guberti/FTC-8103-RelicRecovery/README.md

# ftc_app
Please see https://github.com/EastsidePreparatorySchool/ftc_app. This project has been moved there.
