guberti/FTC-8103-RelicRecovery/Parts/ftc robot/editedThingySlide.stl

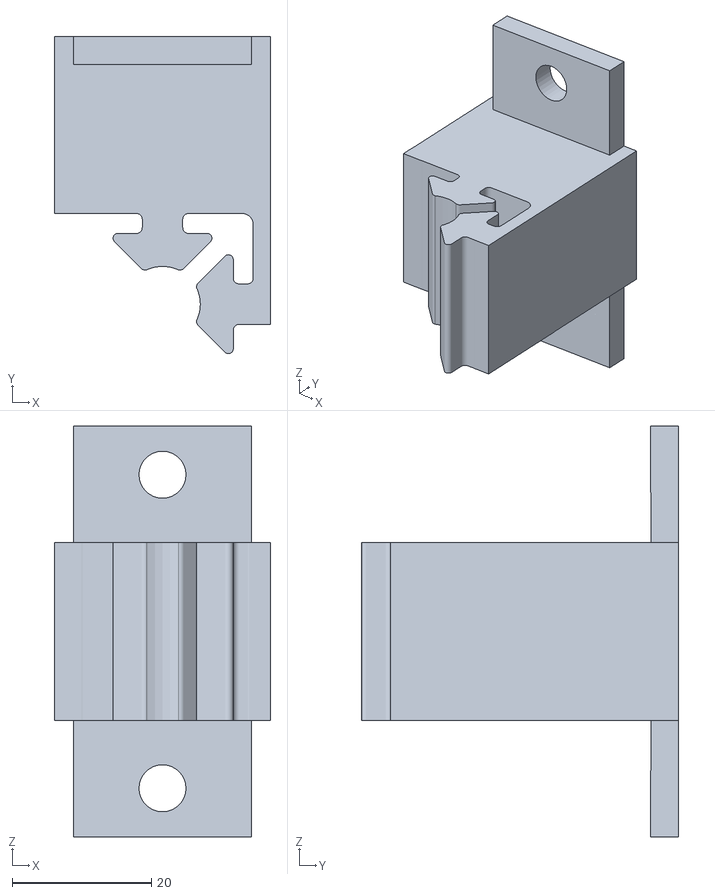
[picture p23: CAD file, 2017-08-23]
Parts/ftc robot/editedThingySlide.stl
31.0 x 45.6 x 59.0
