guberti/FTC-8103-RelicRecovery/Parts/ftc robot/electronics/MRI45-2201_Device_Interface.stp

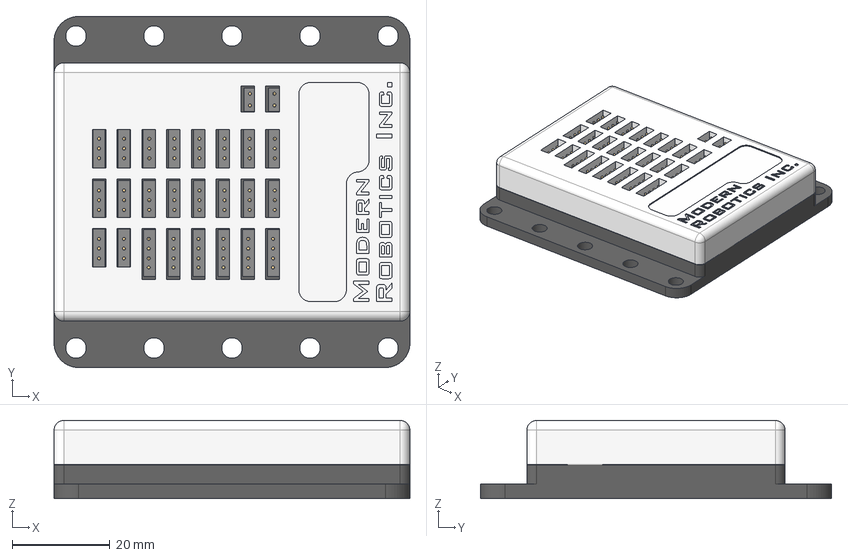
[picture p24: CAD file, 2017-08-23]
Parts/ftc robot/electronics/MRI45-2201_Device_Interface.stp
73.0 x 72.0 x 16.0 mm
