guberti/FTC-8103-RelicRecovery/Parts/Pin Covers/pincovers1.stl

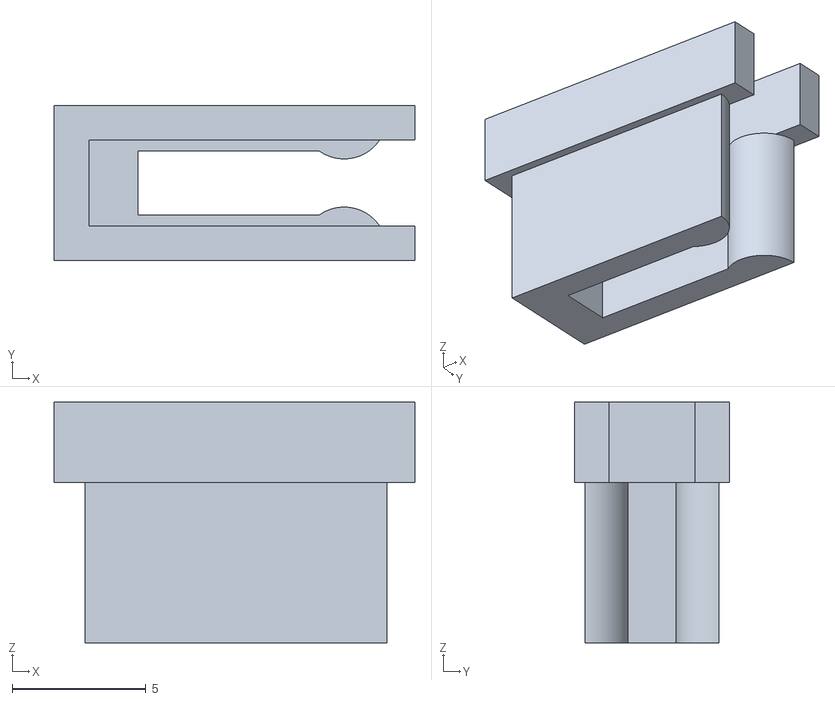
[picture p25: CAD file, 2017-08-22]
Parts/Pin Covers/pincovers1.stl
13.5 x 5.80 x 9.00
