guberti/FTC-8103-RelicRecovery/Projects/Arm/builds/finger.stl

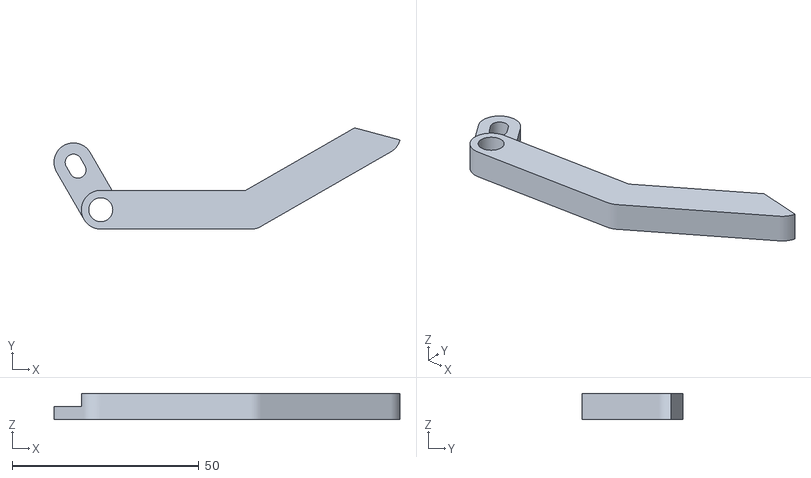
[picture p26: CAD file, 2017-08-22]
Projects/Arm/builds/finger.stl
92.5 x 27.1 x 7.00
