guberti/FTC-8103-RelicRecovery/Projects/ftc robot/shield 2.dxf

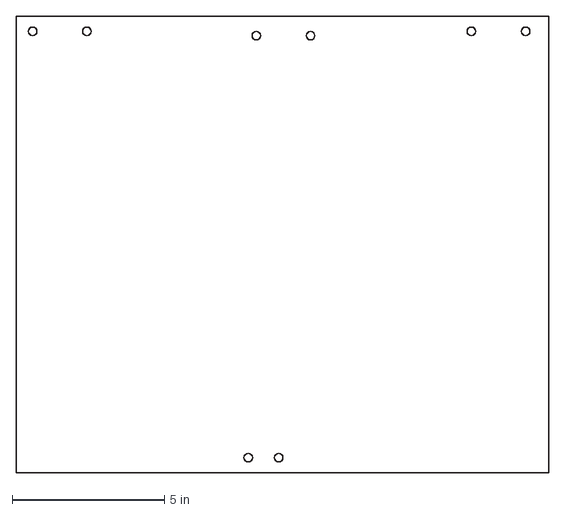
[picture p27: CAD file, 2017-08-23]
Projects/ftc robot/shield 2.dxf
17.5 x 15.0 in
