guberti/FTC-8103-RelicRecovery/Parts/ftc robot/45-2003_Compass.stp

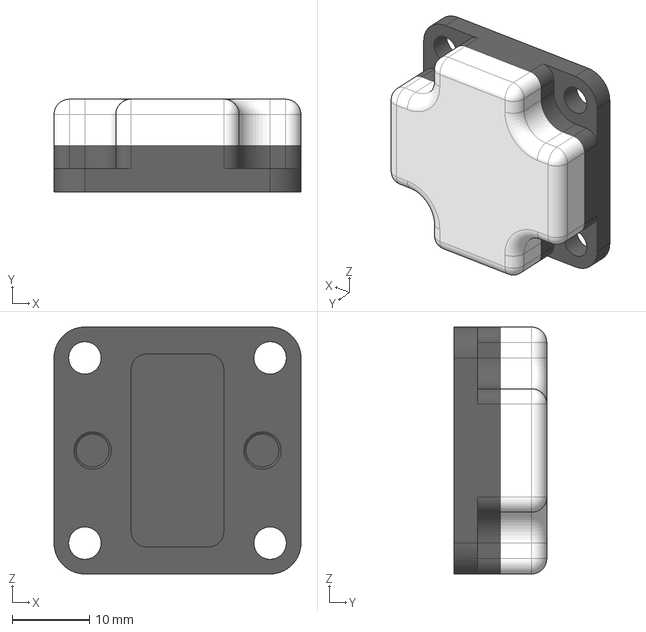
[picture p28: CAD file, 2017-08-23]
Parts/ftc robot/45-2003_Compass.stp
32.0 x 12.0 x 32.0 mm
