guberti/FTC-8103-RelicRecovery/Parts/ftc robot/electronics/MRI45-2204_Servo_Controller.stp

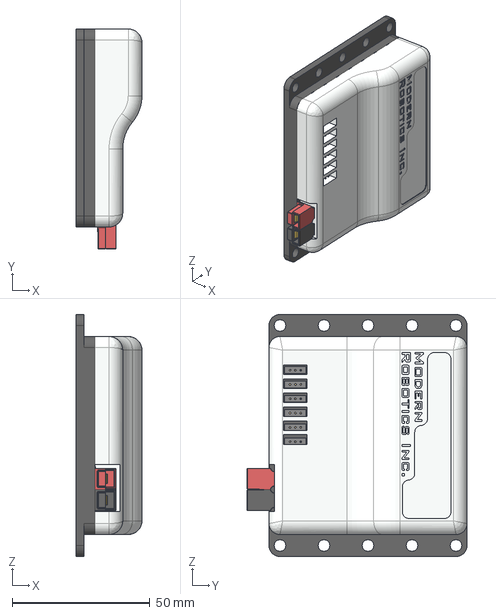
[picture p29: CAD file, 2017-08-23]
Parts/ftc robot/electronics/MRI45-2204_Servo_Controller.stp
24.0 x 80.0 x 88.0 mm
