guberti/FTC-8103-RelicRecovery/Projects/Arm/builds/fingerpin.stl

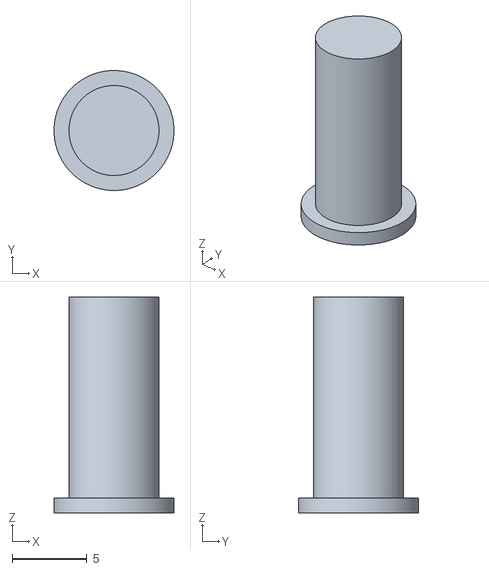
[picture p30: CAD file, 2017-08-22]
Projects/Arm/builds/fingerpin.stl
8.00 x 8.00 x 14.4
