guberti/FTC-8103-RelicRecovery/Projects/ftc robot/45-2017_IRSeekerV3.stp

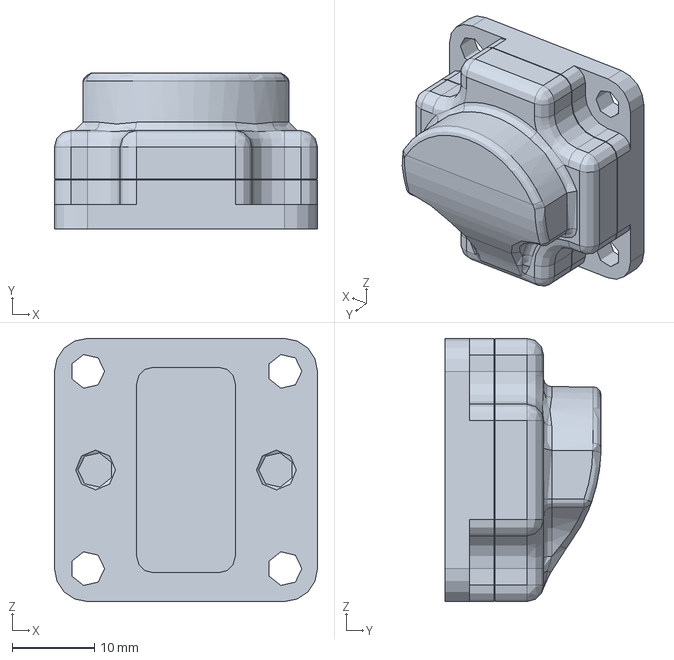
[picture p31: CAD file, 2017-08-23]
Projects/ftc robot/45-2017_IRSeekerV3.stp
32.0 x 19.0 x 32.0 mm
