guberti/FTC-8103-RelicRecovery/Parts/ftc robot/electronics/MRI45-2200_Power_Distribution_Module.stp

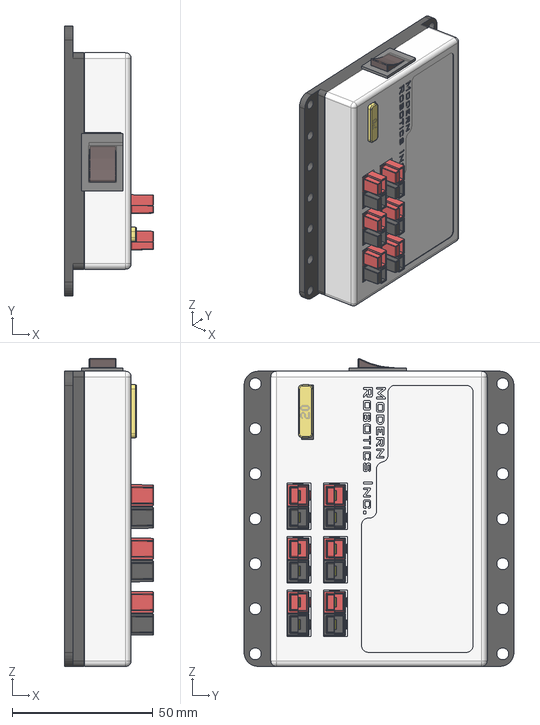
[picture p32: CAD file, 2017-08-23]
Parts/ftc robot/electronics/MRI45-2200_Power_Distribution_Module.stp
31.6 x 96.0 x 109.5 mm
