guberti/FTC-8103-RelicRecovery/Projects/Arm/builds/potentiotest.stl

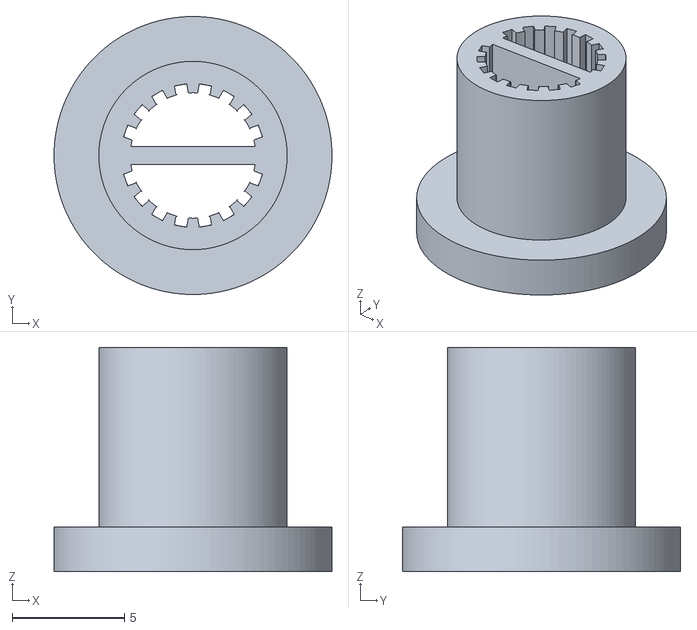
[picture p33: CAD file, 2017-08-22]
Projects/Arm/builds/potentiotest.stl
12.4 x 12.4 x 10.0
