guberti/FTC-8103-RelicRecovery/Parts/ftc robot/45-2018_Color.stp

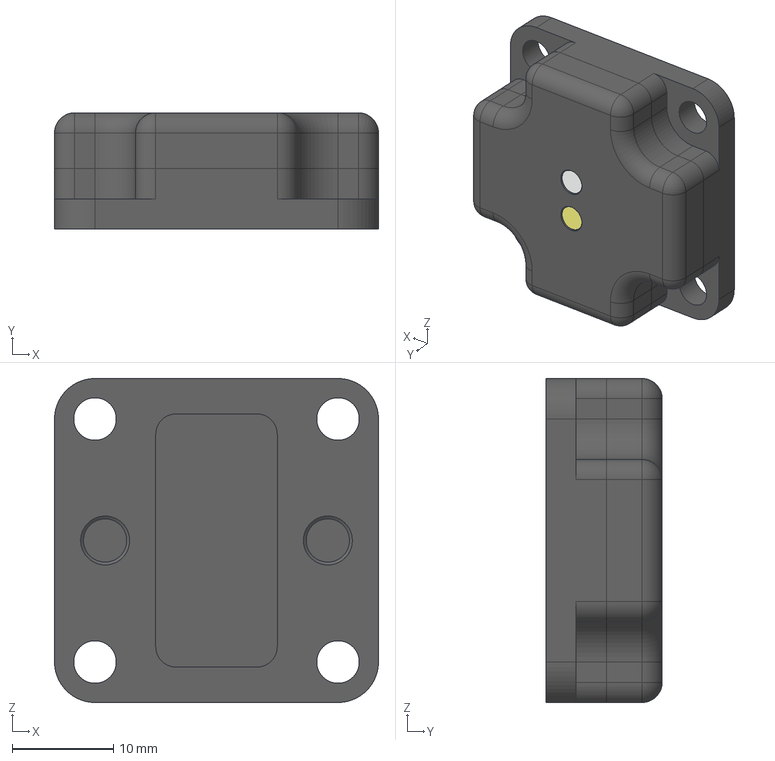
[picture p34: CAD file, 2017-08-23]
Parts/ftc robot/45-2018_Color.stp
32.0 x 11.5 x 32.0 mm
