guberti/FTC-8103-RelicRecovery/Parts/ftc robot/electronics/MRI45-2203_Motor_Controller.stp

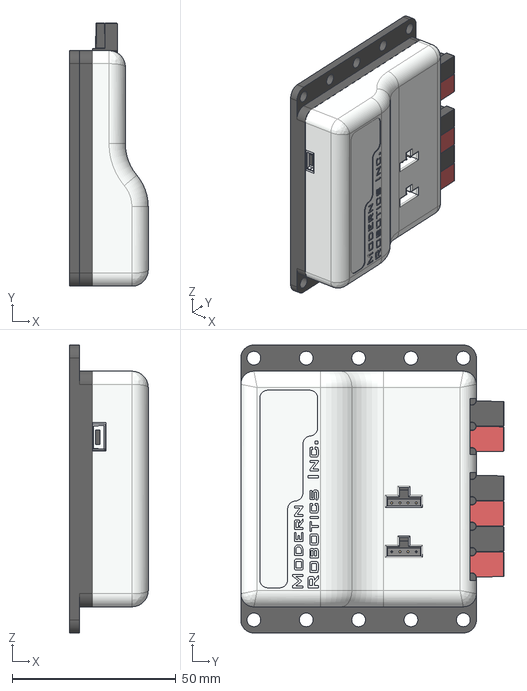
[picture p35: CAD file, 2017-08-23]
Parts/ftc robot/electronics/MRI45-2203_Motor_Controller.stp
24.0 x 80.5 x 88.0 mm
