guberti/FTC-8103-RelicRecovery/Projects/Arm/builds/servoarm1.stl

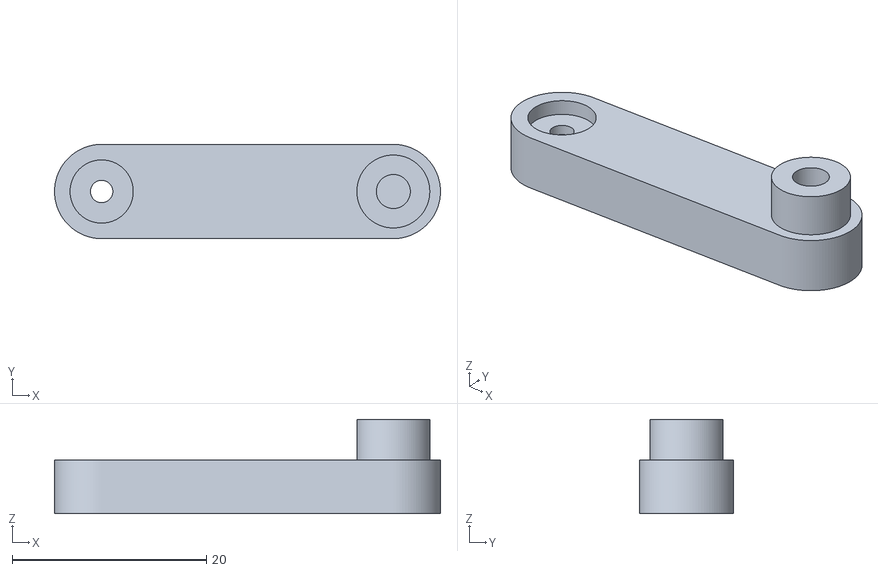
[picture p36: CAD file, 2017-08-22]
Projects/Arm/builds/servoarm1.stl
39.7 x 9.70 x 9.68
