guberti/FTC-8103-RelicRecovery/Projects/Arm/builds/jointpintop.stl

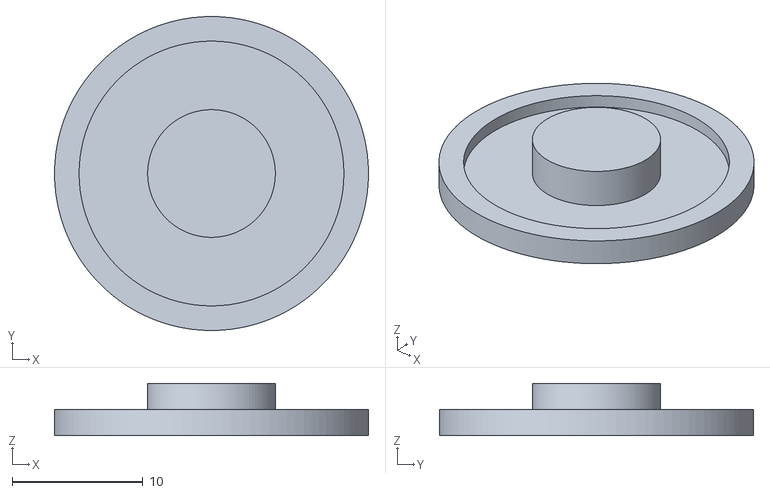
[picture p37: CAD file, 2017-08-22]
Projects/Arm/builds/jointpintop.stl
24.0 x 24.0 x 4.00
