guberti/FTC-8103-RelicRecovery/Projects/Arm/builds/shoulderbracket.stl

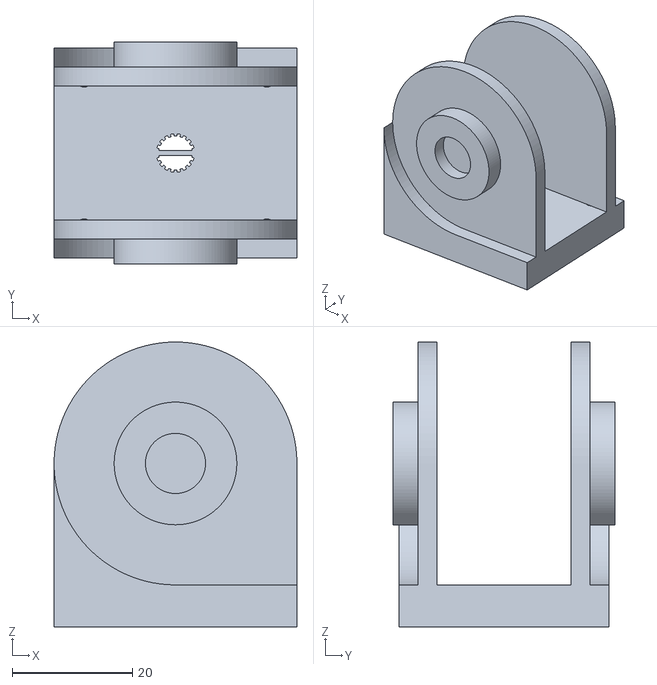
[picture p38: CAD file, 2017-08-22]
Projects/Arm/builds/shoulderbracket.stl
40.4 x 37.0 x 47.4
