guberti/FTC-8103-RelicRecovery/Projects/Arm/builds/jointpin.stl

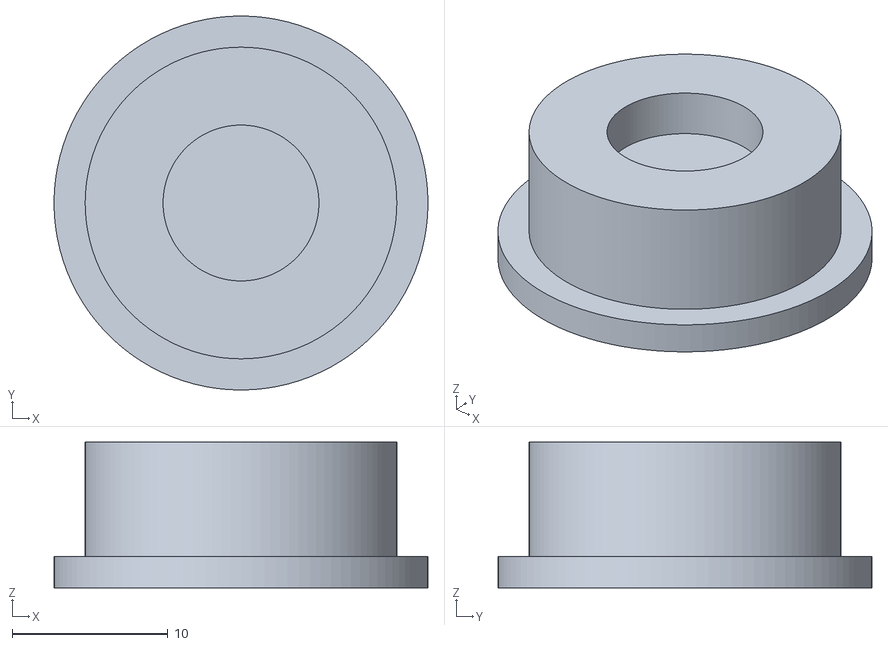
[picture p39: CAD file, 2017-08-22]
Projects/Arm/builds/jointpin.stl
24.0 x 24.0 x 9.35
