guberti/FTC-8103-RelicRecovery/Projects/Arm/builds/hand.stl

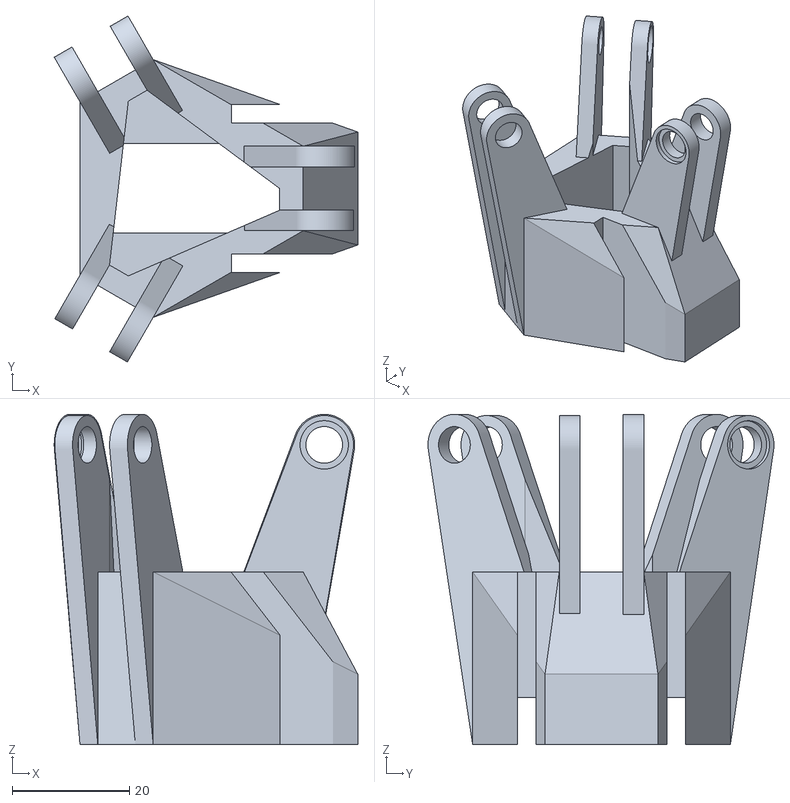
[picture p40: CAD file, 2017-08-22]
Projects/Arm/builds/hand.stl
51.7 x 59.0 x 56.3
