guberti/FTC-8103-RelicRecovery/Projects/Arm/builds/servopintop.stl

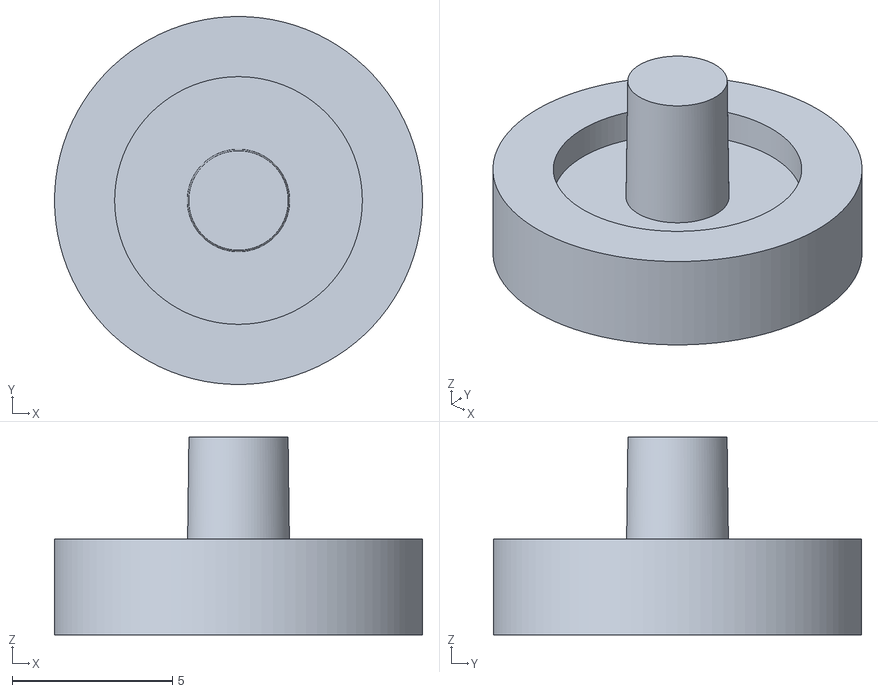
[picture p41: CAD file, 2017-08-22]
Projects/Arm/builds/servopintop.stl
11.5 x 11.5 x 6.17
