guberti/FTC-8103-RelicRecovery/Projects/Arm/builds/fingerpusher.stl

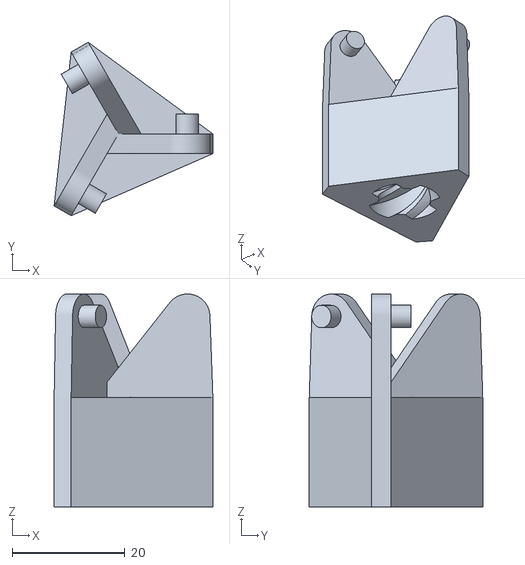
[picture p42: CAD file, 2017-08-22]
Projects/Arm/builds/fingerpusher.stl
28.2 x 30.8 x 37.9
