guberti/FTC-8103-RelicRecovery/Projects/Arm/builds/sntest.stl

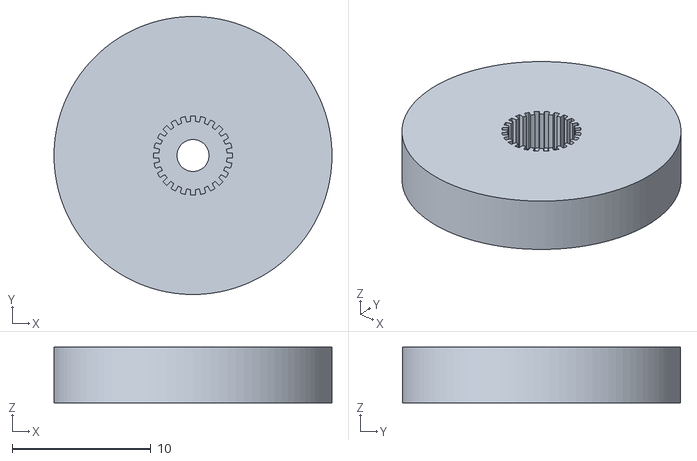
[picture p43: CAD file, 2017-08-22]
Projects/Arm/builds/sntest.stl
20.0 x 20.0 x 4.00
