guberti/FTC-8103-RelicRecovery/Projects/Arm/builds/wheelpin.stl

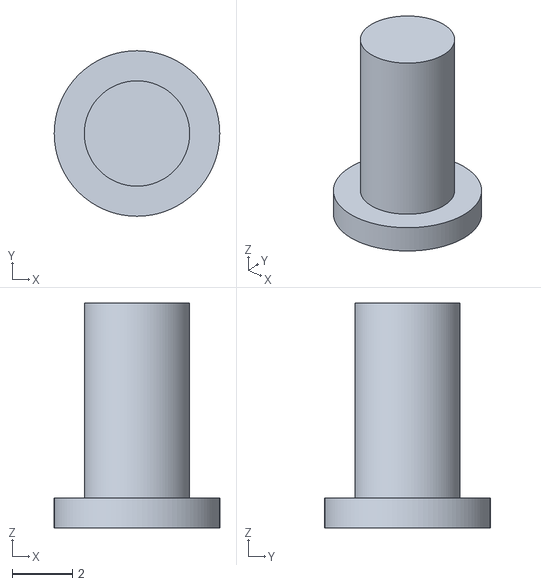
[picture p44: CAD file, 2017-08-22]
Projects/Arm/builds/wheelpin.stl
5.50 x 5.50 x 7.47
