guberti/FTC-8103-RelicRecovery/Projects/Arm/builds/gear.stl

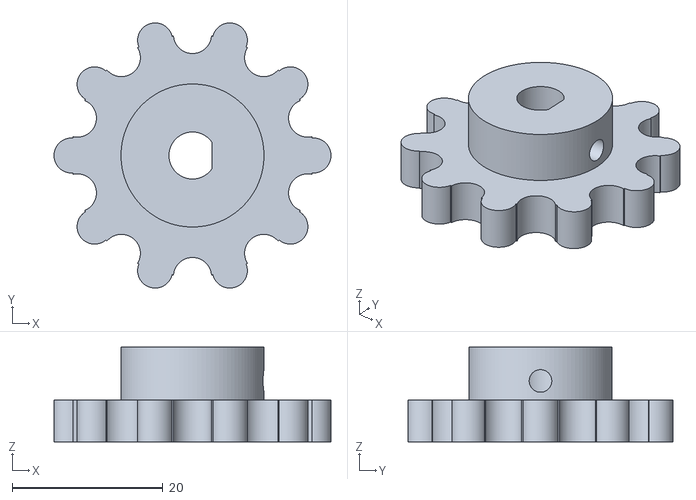
[picture p45: CAD file, 2017-08-22]
Projects/Arm/builds/gear.stl
36.8 x 35.2 x 12.6
