guberti/FTC-8103-RelicRecovery/Projects/Arm/builds/servopintest.stl

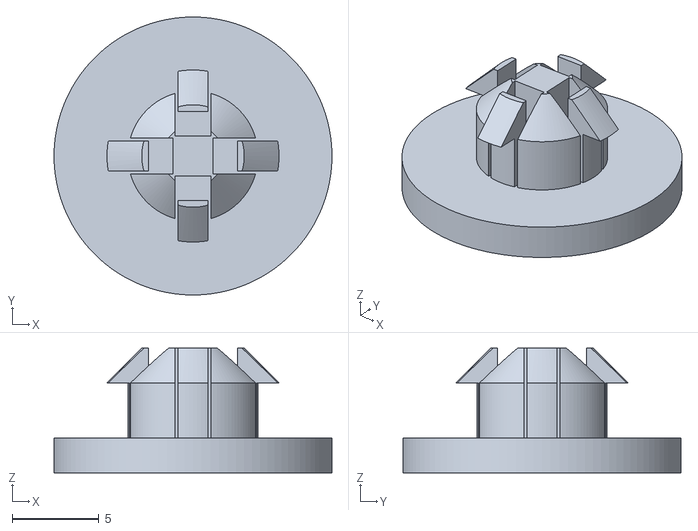
[picture p46: CAD file, 2017-08-22]
Projects/Arm/builds/servopintest.stl
16.0 x 16.0 x 7.17
