guberti/FTC-8103-RelicRecovery/Projects/Arm/builds/servobracket.stl

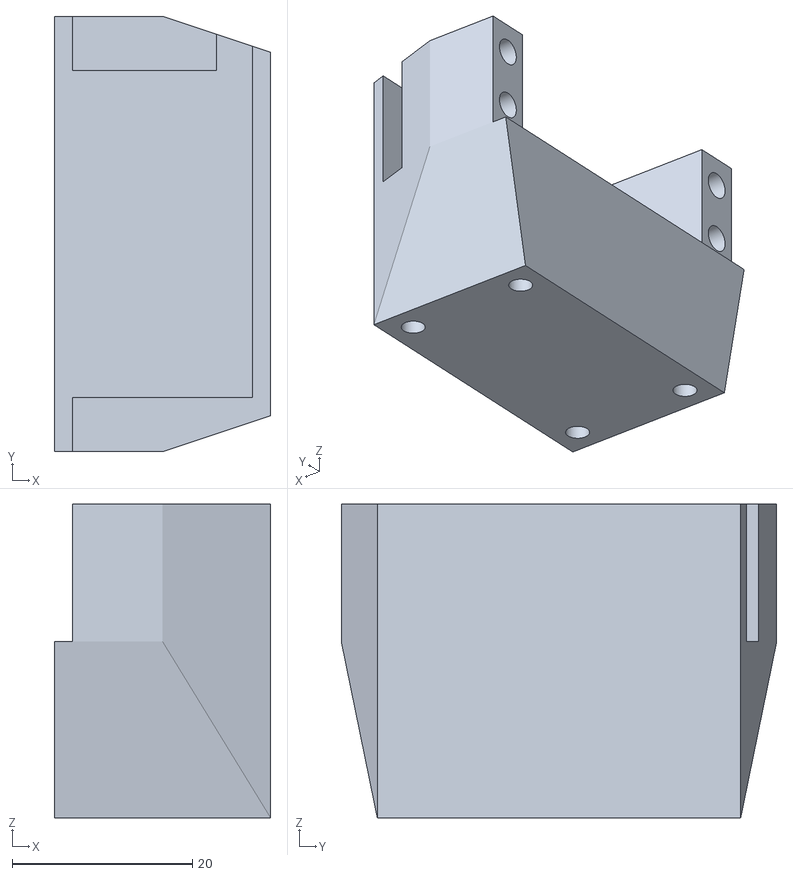
[picture p47: CAD file, 2017-08-22]
Projects/Arm/builds/servobracket.stl
24.0 x 48.3 x 34.8
