guberti/FTC-8103-RelicRecovery/(list of files, cad)

Other CAD files:
Parts/ftc robot/100mm 6mm D axle.ipt
Parts/ftc robot/10HoleExtrudedPlate.STL.ipt
Parts/ftc robot/175mm 6mm D axle.ipt
Parts/ftc robot/45-2003_Compass.ipt
Parts/ftc robot/45-2017_IRSeekerV3.ipt
Parts/ftc robot/45-2018_Color.ipt
Parts/ftc robot/8020 L bracket.ipt
Parts/ftc robot/8020 small L bracket.ipt
Parts/ftc robot/Andymark Motor.ipt
Parts/ftc robot/MRI45-2200_Power_Distribution_Module.ipt
Parts/ftc robot/MRI45-2201_Device_Interface.ipt
Parts/ftc robot/MRI45-2203_Motor_Controller.ipt
Parts/ftc robot/MRI45-2204_Servo_Controller.ipt
Parts/ftc robot/Motor Bracket.ipt
Parts/ftc robot/OldVersions/175mm 6mm D axle.0003.ipt
Parts/ftc robot/OldVersions/ShieldSlideAttachment2-SFK.0002.ipt
Parts/ftc robot/OldVersions/circuit board correct.0001.ipt
Parts/ftc robot/OldVersions/extruded aluminum (horizontal).0002.ipt
Parts/ftc robot/OldVersions/extruded aluminum (vertical) - Copy.0001.ipt
Parts/ftc robot/OldVersions/extruded aluminum (vertical).0001.ipt
Parts/ftc robot/OldVersions/ftc robot.0012.iam
Parts/ftc robot/OldVersions/phone turning.0003.iam
Parts/ftc robot/OldVersions/side shield.0001.ipt
Parts/ftc robot/OldVersions/spacer2.0001.ipt
Parts/ftc robot/ShieldSlideAttachment2-SFK.ipt
Parts/ftc robot/circuit board correct.ipt
Parts/ftc robot/electronics/MRI45-2202_Legacy_Module.stp
Parts/ftc robot/extracted/OldVersions/SAMANTHA_CASE_BOTTOM_2012.0001.ipt
Parts/ftc robot/extracted/OldVersions/SAMANTHA_CASE_TOP_2012.0001.ipt
Parts/ftc robot/extracted/OldVersions/TETRIX_731132_BEARING_2012.0001.ipt
Parts/ftc robot/extracted/OldVersions/TETRIX_731132_HUB_2012.0001.ipt
Parts/ftc robot/extracted/OldVersions/TETRIX_731132_ROLLER_2012.0001.iam
Parts/ftc robot/extracted/OldVersions/TETRIX_731132_ROLLER_AXLE_2012.0001.ipt
Parts/ftc robot/extracted/OldVersions/TETRIX_731132_SCREW_2012.0001.ipt
Parts/ftc robot/extracted/OldVersions/TETRIX_731132_SUB_ROLLER_2012.0001.ipt
Parts/ftc robot/extracted/OldVersions/TETRIX_736466_BEARING_2012.0001.ipt
Parts/ftc robot/extracted/OldVersions/TETRIX_736466_HUB_2012.0001.ipt
Parts/ftc robot/extracted/OldVersions/TETRIX_736466_ROLLER_2012.0001.iam
Parts/ftc robot/extracted/OldVersions/TETRIX_736466_ROLLER_2012.0001.ipt
Parts/ftc robot/extracted/OldVersions/TETRIX_736466_ROLLER_AXLE_2012.0001.ipt
Parts/ftc robot/extracted/OldVersions/TETRIX_736466_SCREW_2012.0002.ipt
Parts/ftc robot/extracted/OldVersions/TETRIX_736468_TT_INSERT_2012.0001.ipt
Parts/ftc robot/extracted/OldVersions/TETRIX_736468_TT_LINK_2012.0001.ipt
Parts/ftc robot/extracted/OldVersions/TETRIX_739020-HORN_2013-2.0001.ipt
Parts/ftc robot/extracted/OldVersions/TETRIX_739020-HORN_2013.0003.ipt
Parts/ftc robot/extracted/OldVersions/TETRIX_739020-SCREW_2013.0004.ipt
Parts/ftc robot/extracted/OldVersions/TETRIX_739020_2013.0003.iam
Parts/ftc robot/extracted/OldVersions/TETRIX_739079_COLLAR_2012.0001.ipt
Parts/ftc robot/extracted/OldVersions/TETRIX_739079_SCREW_2012.0001.ipt
Parts/ftc robot/extracted/OldVersions/TETRIX_739083_AXLE_2012.0001.ipt
Parts/ftc robot/extracted/OldVersions/TETRIX_739083_MOTOR_2012.0001.ipt
Parts/ftc robot/extracted/OldVersions/TETRIX_739088_2013.0001.ipt
Parts/ftc robot/extracted/OldVersions/TETRIX_739091_2013.0001.ipt
Parts/ftc robot/extracted/OldVersions/TETRIX_739092_COLLAR_2012.0001.ipt
Parts/ftc robot/extracted/OldVersions/TETRIX_739092_SCREW_2012.0001.ipt
Parts/ftc robot/extracted/OldVersions/TETRIX_739094_2012.0001.ipt
Parts/ftc robot/extracted/OldVersions/TETRIX_739097_2012.0001.ipt
Parts/ftc robot/extracted/OldVersions/TETRIX_739136_AA_2013.0001.ipt
Parts/ftc robot/extracted/OldVersions/TETRIX_739136_BAT_8_AA_2013.0001.ipt
Parts/ftc robot/extracted/OldVersions/TETRIX_739136_BLACK_WIRE_2013.0001.ipt
Parts/ftc robot/extracted/OldVersions/TETRIX_739136_RED_WIRE_2013.0001.ipt
Parts/ftc robot/extracted/OldVersions/TETRIX_739172_COLLAR_2012.0002.ipt
Parts/ftc robot/extracted/OldVersions/TETRIX_739172_SCREW_2012.0001.ipt
Parts/ftc robot/extracted/OldVersions/TETRIX_739177_CR_SERVO_4-1_2013.0001.ipt
Parts/ftc robot/extracted/OldVersions/TETRIX_739177_SCREW_2013.0001.ipt
Parts/ftc robot/extracted/OldVersions/TETRIX_739195_2012.0001.ipt
Parts/ftc robot/extracted/OldVersions/TETRIX_739197_METAL_HORN_2012.0001.ipt
Parts/ftc robot/extracted/OldVersions/TETRIX_739197_PLASTIC_HORN_2012.0001.ipt
Parts/ftc robot/extracted/OldVersions/TETRIX_739197_SCREW_2012.0001.ipt
Parts/ftc robot/extracted/OldVersions/TETRIX_739197_SERVO_2012.0001.ipt
Parts/ftc robot/extracted/OldVersions/TETRIX_739217_CHN_BREAK_25_2013.0001.ipt
Parts/ftc robot/extracted/OldVersions/TETRIX_739217_SCREW_2013.0001.ipt
Parts/ftc robot/extracted/OldVersions/TETRIX_739275_BODY_2013.0001.ipt
Parts/ftc robot/extracted/OldVersions/TETRIX_739275_SCREW_2013.0001.ipt
Parts/ftc robot/extracted/OldVersions/TETRIX_739276_BODY_2013.0001.ipt
Parts/ftc robot/extracted/OldVersions/TETRIX_739276_SCREW_2013.0001.ipt
Parts/ftc robot/extracted/OldVersions/TETRIX_739278_TIRE_AX_HUB_2013.0001.ipt
Parts/ftc robot/extracted/OldVersions/TETRIX_739282_ALL-TER_TIRE_2013.0001.ipt
Parts/ftc robot/extracted/OldVersions/TETRIX_739282_ALL-TER_WH_2013.0001.ipt
Parts/ftc robot/extracted/OldVersions/TETRIX_739300X101200_2013.0001.ipt
Parts/ftc robot/extracted/OldVersions/TETRIX_739300X101201_2013.0001.ipt
Parts/ftc robot/extracted/OldVersions/TETRIX_739300X101202_2013.0001.ipt
Parts/ftc robot/extracted/OldVersions/TETRIX_739300X101203_2013.0001.ipt
Parts/ftc robot/extracted/OldVersions/TETRIX_739375X108105_4-1_2013.0001.iam
Parts/ftc robot/extracted/OldVersions/TETRIX_739375X108107_4-1_2013.0001.iam
Parts/ftc robot/extracted/OldVersions/TETRIX_739375X108111_2013.0001.ipt
Parts/ftc robot/extracted/OldVersions/TETRIX_739375X108112_2013.0001.ipt
Parts/ftc robot/extracted/OldVersions/TETRIX_739375X108114_2013.0001.ipt
Parts/ftc robot/extracted/OldVersions/TETRIX_739375X108127_2013.0001.ipt
Parts/ftc robot/extracted/OldVersions/TETRIX_739376X108124_2013.0001.ipt
Parts/ftc robot/extracted/OldVersions/TETRIX_739376X108128_2013.0001.ipt
Parts/ftc robot/extracted/OldVersions/TETRIX_739376X108129_2013.0001.ipt
Parts/ftc robot/extracted/OldVersions/TETRIX_739383_2013.0001.ipt
Parts/ftc robot/extracted/OldVersions/TETRIX_739386_2013.0001.ipt
Parts/ftc robot/extracted/OldVersions/TETRIX_739900X108133_10-1_2013.0001.ipt
Parts/ftc robot/extracted/OldVersions/TETRIX_739900X108135_2013.0001.ipt
Parts/ftc robot/extracted/OldVersions/TETRIX_739900X108136_2013.0001.ipt
Parts/ftc robot/extracted/OldVersions/TETRIX_739901X108011_20-1_2013.0001.iam
Parts/ftc robot/extracted/OldVersions/TETRIX_739901X108012_20-1_2013.0001.iam
Parts/ftc robot/extracted/OldVersions/TETRIX_739901X108135_2013.0001.ipt
Parts/ftc robot/extracted/OldVersions/TETRIX_739901X108136_2013.0001.ipt
Parts/ftc robot/extracted/OldVersions/TETRIX_739901X108138_20-1_2013.0001.ipt
Parts/ftc robot/extracted/OldVersions/TETRIX_739904-SER_HS-755HB_2013.0001.ipt
Parts/ftc robot/extracted/OldVersions/TETRIX_739905-SER_HORN_2014.0001.ipt
Parts/ftc robot/extracted/OldVersions/TETRIX_739905-SER_HS-785HB_2013.0001.ipt
Parts/ftc robot/extracted/OldVersions/TETRIX_739905_SCREW_2013.0001.ipt
Parts/ftc robot/extracted/OldVersions/samantha_module_2012.0001.iam
Parts/ftc robot/extracted/OldVersions/tetrix_731132_2012.0001.iam
Parts/ftc robot/extracted/OldVersions/tetrix_731132_2012.0002.iam
Parts/ftc robot/extracted/OldVersions/tetrix_731901_120_2013.0001.ipt
Parts/ftc robot/extracted/OldVersions/tetrix_731901_40_2013.0002.ipt
Parts/ftc robot/extracted/OldVersions/tetrix_731901_80_2013.0001.ipt
Parts/ftc robot/extracted/OldVersions/tetrix_731903_2012.0001.ipt
Parts/ftc robot/extracted/OldVersions/tetrix_735871_2012.0001.ipt
Parts/ftc robot/extracted/OldVersions/tetrix_736466_2012.0001.iam
Parts/ftc robot/extracted/OldVersions/tetrix_736466_joining_hub.0001.ipt
Parts/ftc robot/extracted/OldVersions/tetrix_736468_tt_2012.0001.iam
Parts/ftc robot/extracted/OldVersions/tetrix_736468_tt_paddle_2012.0001.ipt
Parts/ftc robot/extracted/OldVersions/tetrix_736468_tt_sprocket_2012.0001.ipt
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
