guberti/FTC-8103-RelicRecovery/Parts/Central Circuit Board/Final 2017-2018 Circuit Board.pdf

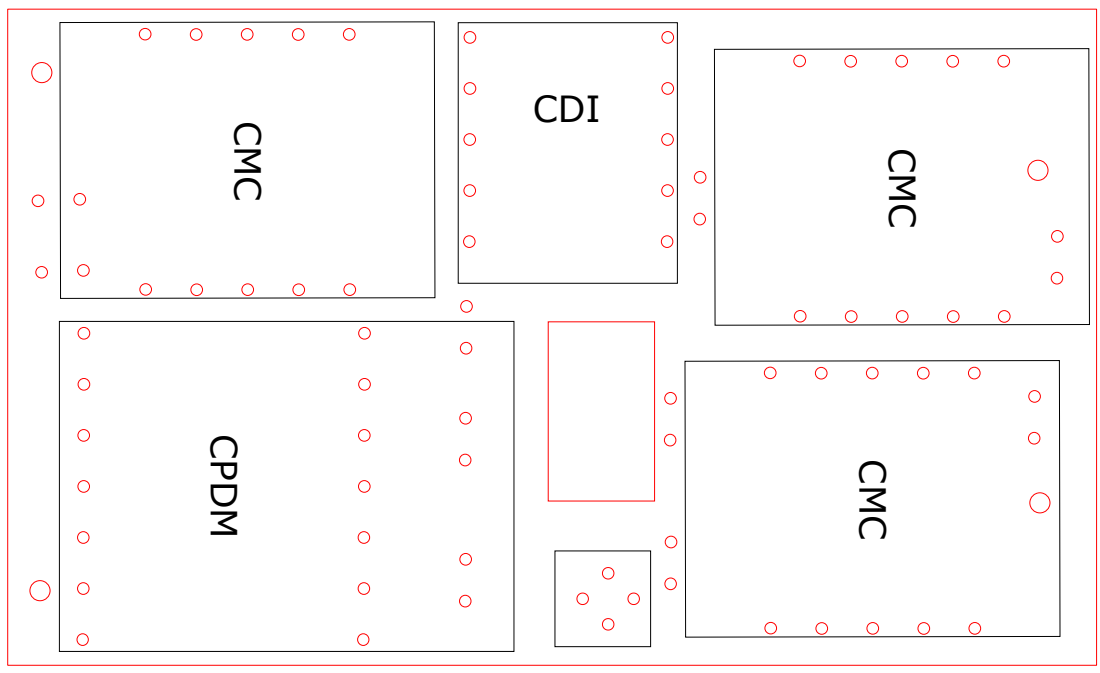
[picture p63: page 1]
CMC; CPDM CMC; CDI
