guberti/FTC-8103-RelicRecovery/Projects/Arm/gcode/a bunch of stuff.pdf

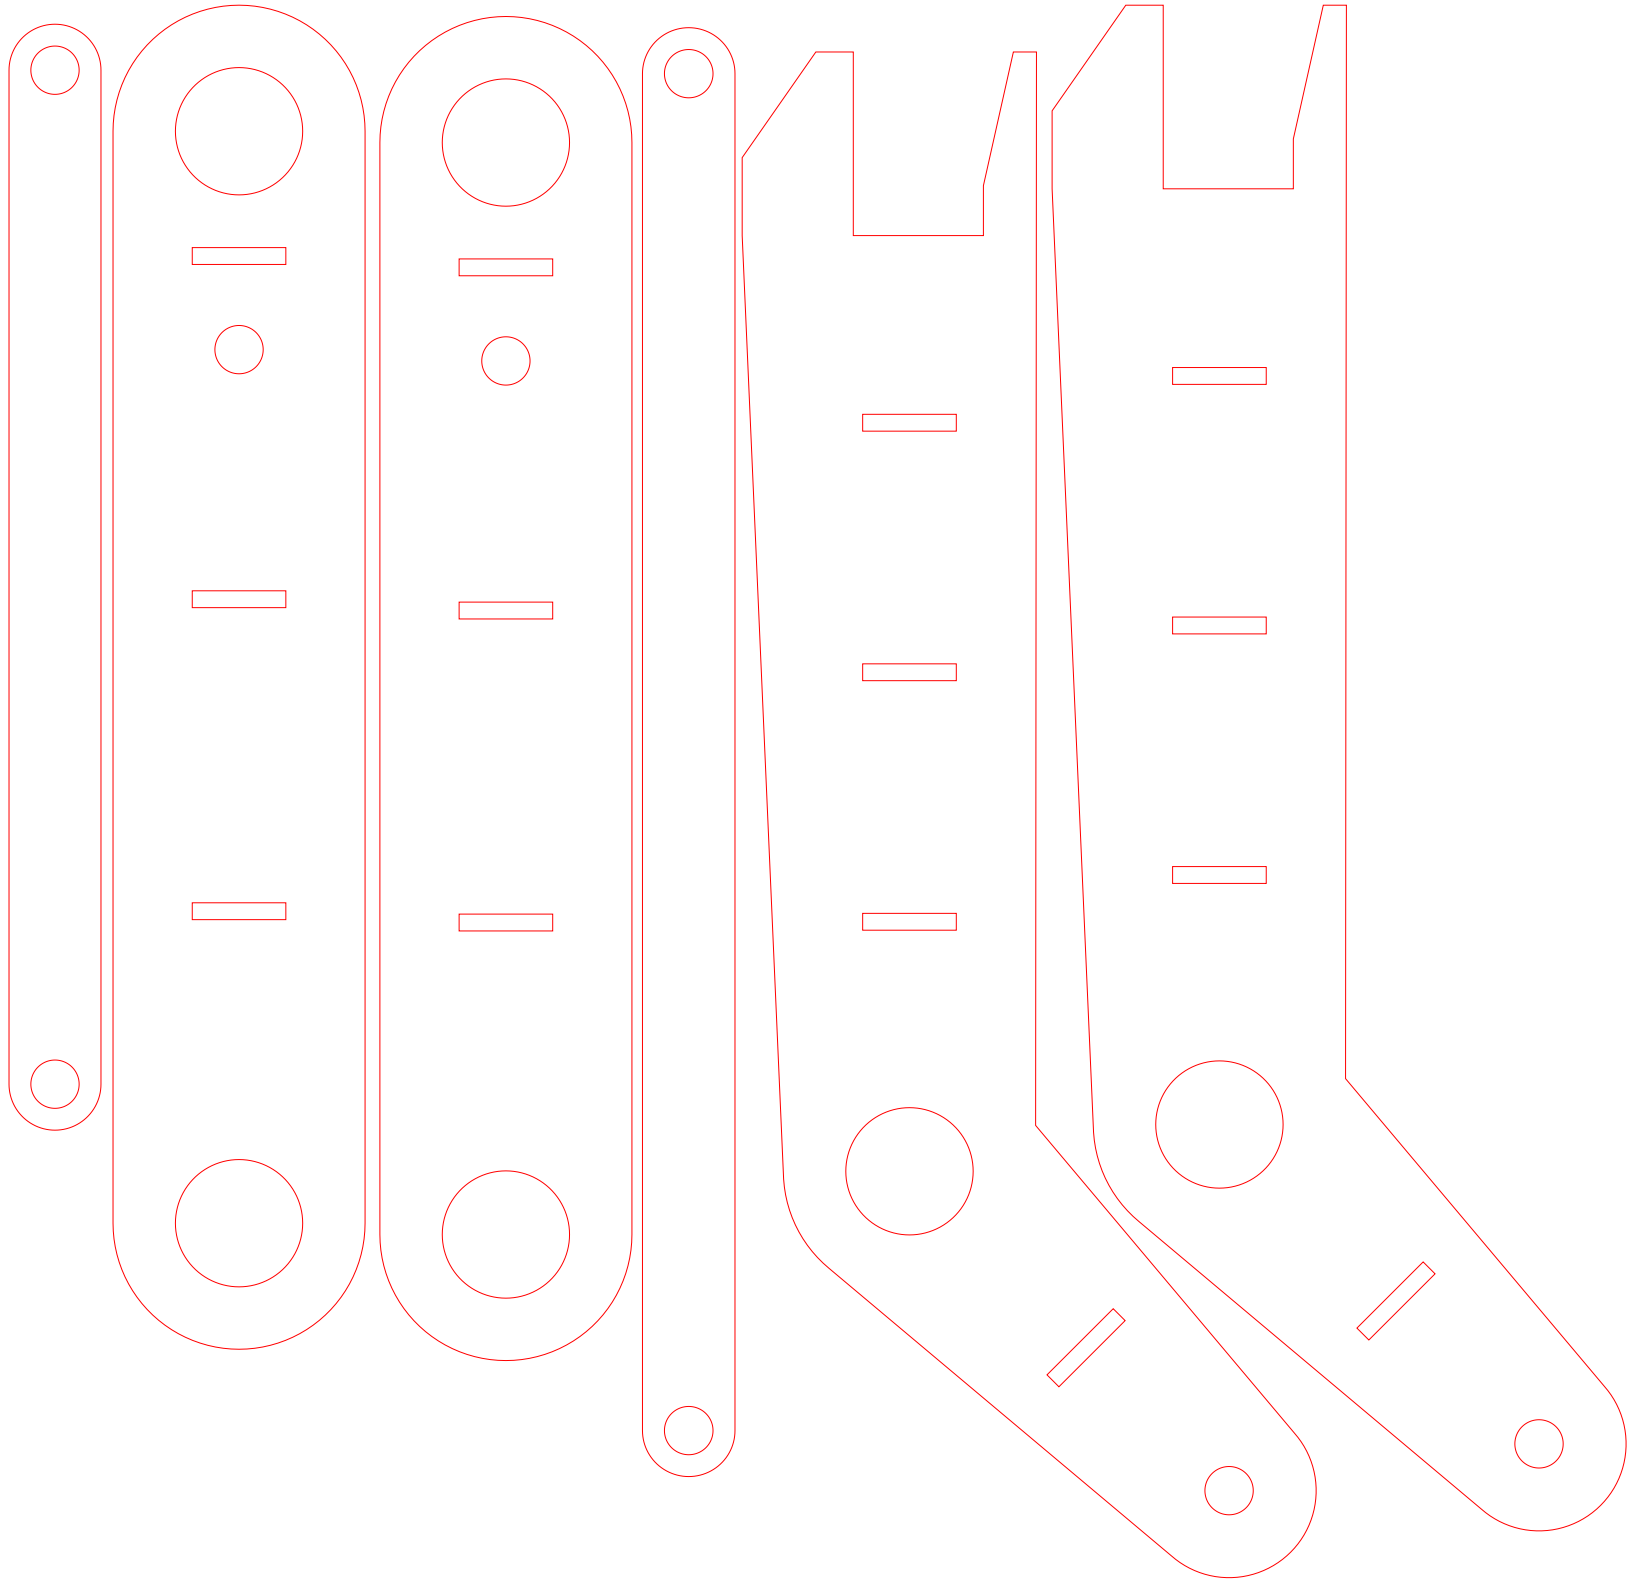
[picture p64: page 1]
