guberti/FTC-8103-RelicRecovery/Projects/Arm/gcode/forearm.pdf

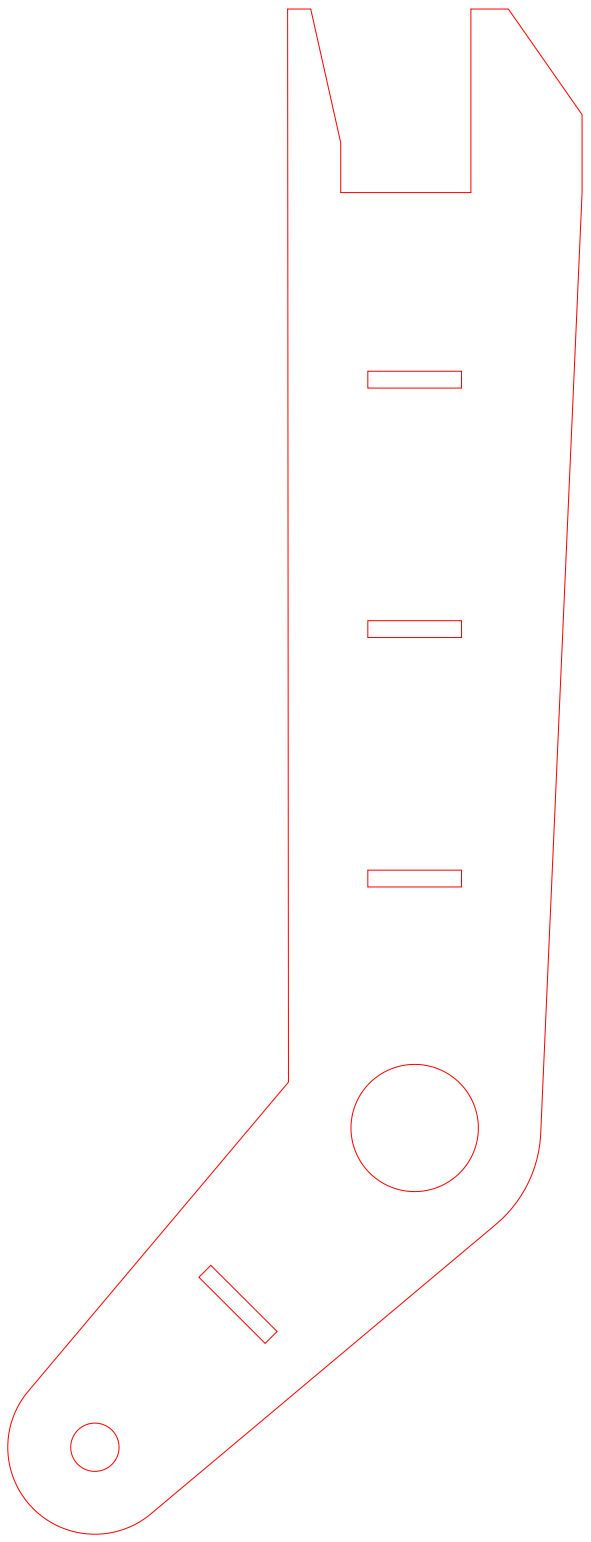
[picture p65: page 1]
