guberti/FTC-8103-RelicRecovery/(commit log)

2017-08-23 robot parts
    everything
    [100mm 6mm D axle.ipt, 1020-1-CL.0002.ipt, 1020-1-CL.ipt, 10HoleExtrudedPlate.STL.ipt, 175mm 6mm D axle.0003.ipt, 175mm 6mm D axle.ipt, 3058.0001.ipt, 3058.ipt]
2017-08-23 putting stuff in different places
    [100mm 6mm D axle.ipt, 1020-1-CL.0002.ipt, 1020-1-CL.ipt, 10HoleExtrudedPlate.STL.ipt, 175mm 6mm D axle.0003.ipt, 175mm 6mm D axle.ipt, 3058.0001.ipt, 3058.ipt]
2017-08-23 some stuff probably
    [parts.scad, pincovers1.stl, utils.scad, verticalsensormount.scad]
2017-08-24 File Re-name
    [ShieldSlideAttachment2-SFK.ipt]
2017-08-24 added battery holder folder
    [batterymount1-awhitmer.scad]
2017-08-24 Part updates
    [parts.scad, verticalsensormount.scad]
2017-08-24 battery work
    [batterymount1-awhitmer.dxf, batterymount1-awhitmer.scad]
2017-08-31 Added scad variables and also a sensor mount
    [batterymount1-awhitmer.dxf, parts.scad, switchmount1-qbowers.scad, tslot.dxf, variables.scad, verticalsensormount.scad, verticalsensormount1-qbowers.scad, verticalsensormount1-qbowers.stl]
2017-09-05 part modifications
    [parts.scad, switchmount1-qbowers.scad, variables.scad, verticalsensormount1-qbowers.scad, verticalsensormount2-qbowers.scad]
2017-09-06 phone mount
    [144mmLBracket1-SFK.ipt, PhoneCase-SFK.ipt, PhoneFlipper1-SFK.0007.iam, PhoneFlipper1-SFK.iam, Servo.0010.iam, Servo.iam, ShieldSlideAttachment2-SFK.0002.ipt, ShieldSlideAttachment2-SFK.ipt]
2017-09-06 old version
    [ftc robot.0010.iam]
2017-09-06 Revert "Merge remote-tracking branch 'origin/master'"
    This reverts commit 1b379c8552a997b8dcd4fc8f1f9e2e3ca69319aa, reversing
    changes made to 145b831ef6cc211c7d3108699821c55bf4c328ba.
    [100mm 6mm D axle.ipt, 1020-1-CL.0002.ipt, 1020-1-CL.ipt, 10HoleExtrudedPlate.STL.ipt, 175mm 6mm D axle.0003.ipt, 175mm 6mm D axle.ipt, 3058.0001.ipt, 3058.ipt]
